VitMain/BLE-Micro-Pro/bmp-boost/bmp-boost-led-extender/bmp-boost-led-extender.kicad_pcb

## KiCad design bmp-boost/bmp-boost-led-extender/bmp-boost-led-extender.kicad_pcb (2026-06-03)

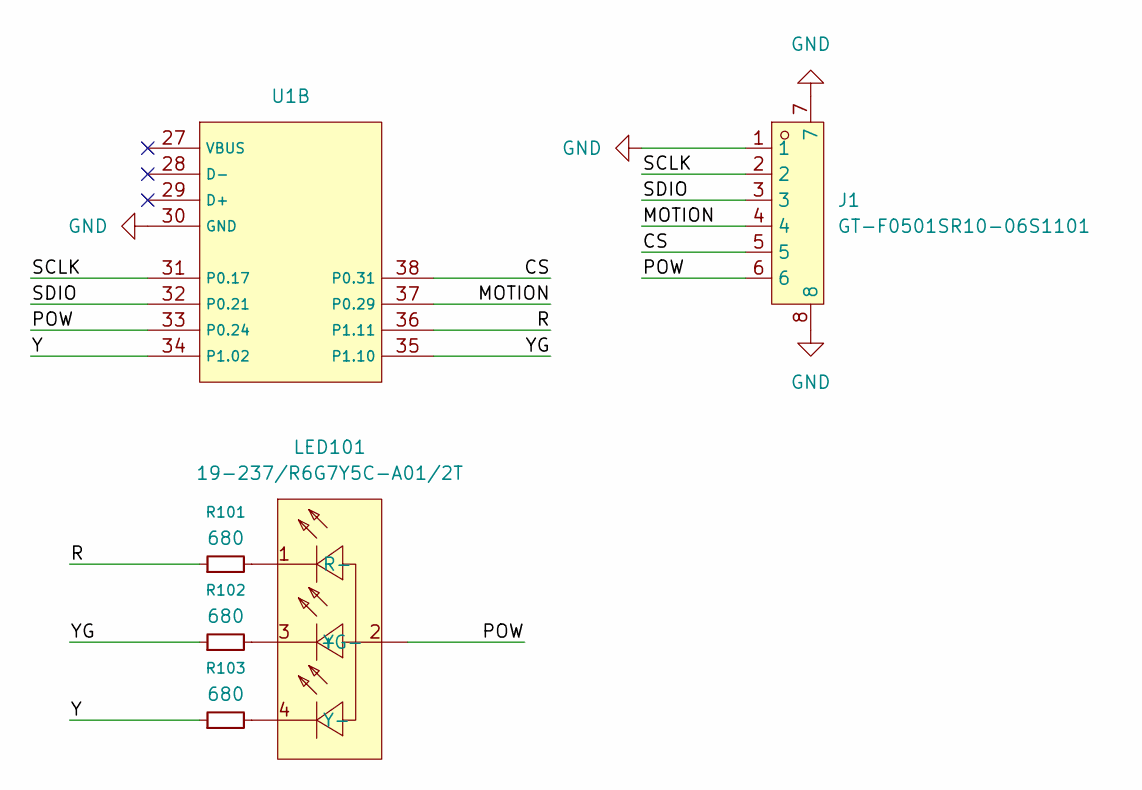
[picture p5: schematic bmp-boost-led-extender.kicad_sch]

Parts:
J1: GT-F0501SR10-06S1101; FPC-SMD_6P-P0.50_GT-F0501SR10-06S1101; LCSC Part C22380676
LED101: 19-237/R6G7Y5C-A01/2T; LED-ARRAY-SMD_4P-L1.6-W1.6-BL-CW; LCSC Part C264510
R101, R102, R103: 680; R_0603_1608Metric
U1: BMP-Boost-full

Connections:
/CS: J1.5, U1.38 (P0.31)
/MOTION: J1.4, U1.37 (P0.29)
/POW: J1.6, LED101.2 (+), U1.33 (P0.24)
/R: R101.1, U1.36 (P1.11)
/SCLK: J1.2, U1.31 (P0.17)
/SDIO: J1.3, U1.32 (P0.21)
/Y: R103.1, U1.34 (P1.02)
/YG: R102.1, U1.35 (P1.10)
GND: J1.1, J1.7, J1.8, U1.30 (GND)
unnamed: LED101.1 (R-), R101.2
unnamed: LED101.4 (Y-), R103.2
unnamed: LED101.3 (YG-), R102.2

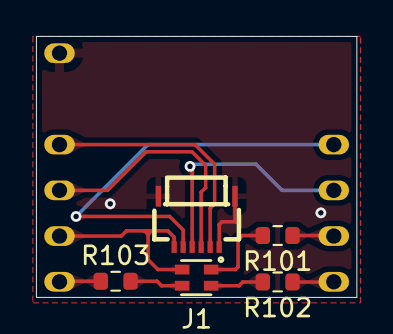
[picture p6: board bmp-boost-led-extender.kicad_pcb from above]

Board: 2 copper layers, 17.8 x 14.5 mm, 6 parts (0 on the bottom side), 12 nets.
