VitMain/BLE-Micro-Pro/bmp-boost/bmp-boost-extender/bmp-boost-extender.kicad_pcb

## KiCad design bmp-boost/bmp-boost-extender/bmp-boost-extender.kicad_pcb (2025-12-13)

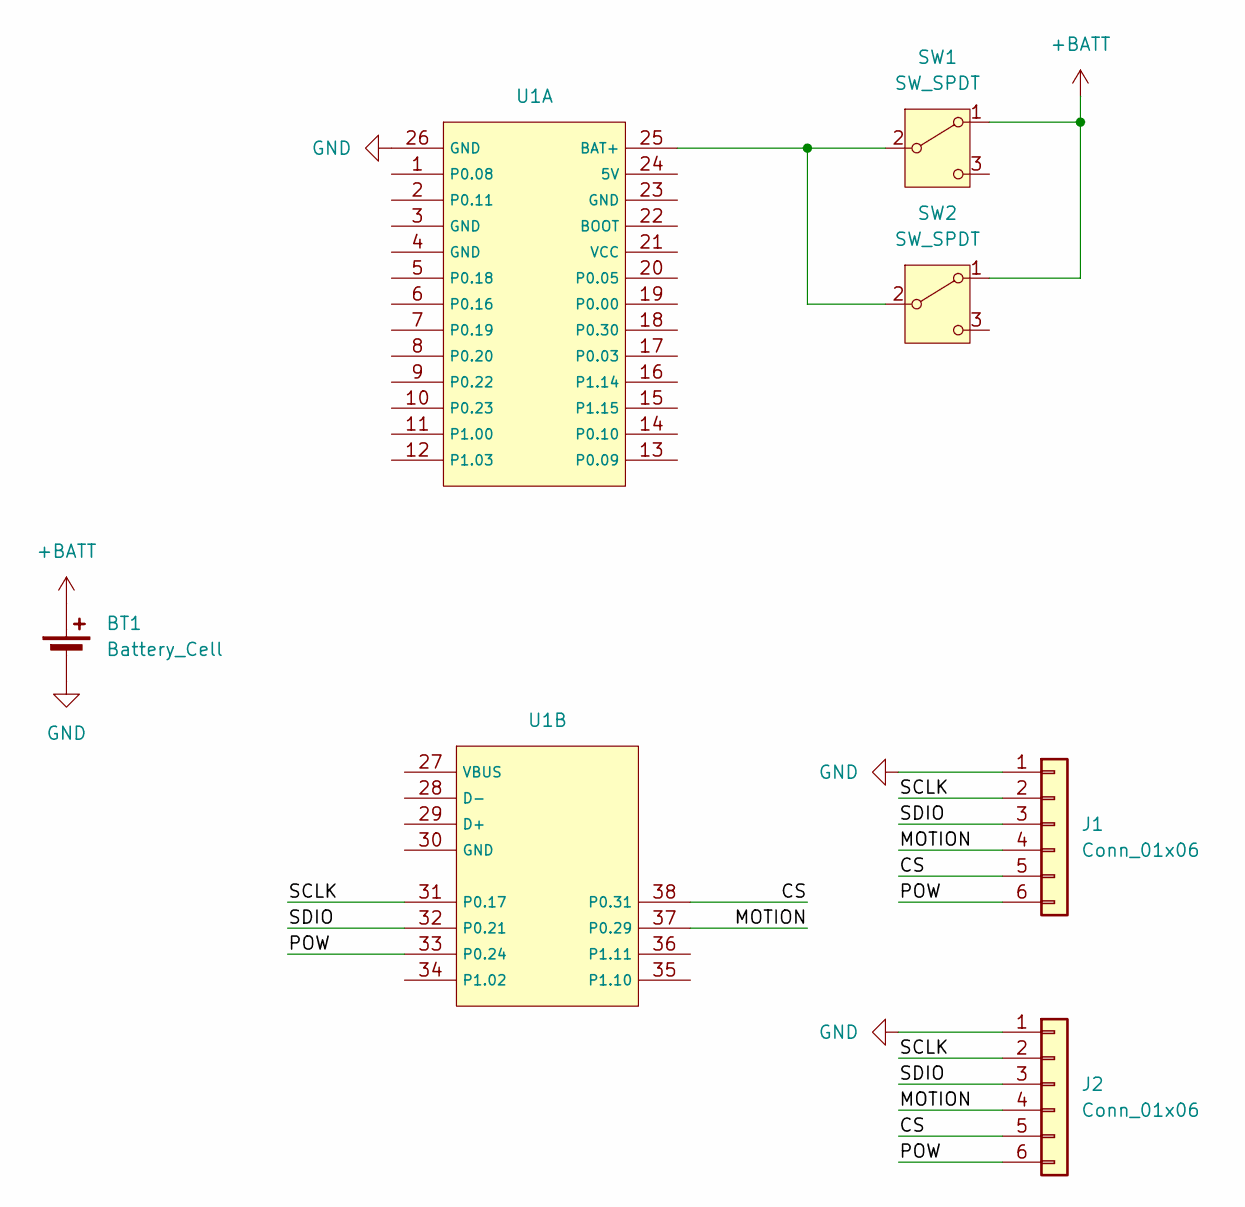
[picture p7: schematic bmp-boost-extender.kicad_sch]

Parts:
BT1: Battery_Cell; AAA_Battery_DIP
J1, J2: Conn_01x06; ffc-6p-adapter
SW1, SW2: SW_SPDT; ISH-1260-HA-G
U1: BMP-Boost-full

Connections:
+BATT: BT1.1 (+), SW1.1 (A), SW2.1 (A)
/CS: J1.5, J2.5, U1.38 (P0.31)
/MOTION: J1.4, J2.4, U1.37 (P0.29)
/POW: J1.6, J2.6, U1.33 (P0.24)
/SCLK: J1.2, J2.2, U1.31 (P0.17)
/SDIO: J1.3, J2.3, U1.32 (P0.21)
GND: BT1.2 (-), J1.1, J2.1, U1.26 (GND)
unnamed: SW1.2 (B), SW2.2 (B), U1.25 (BAT+)

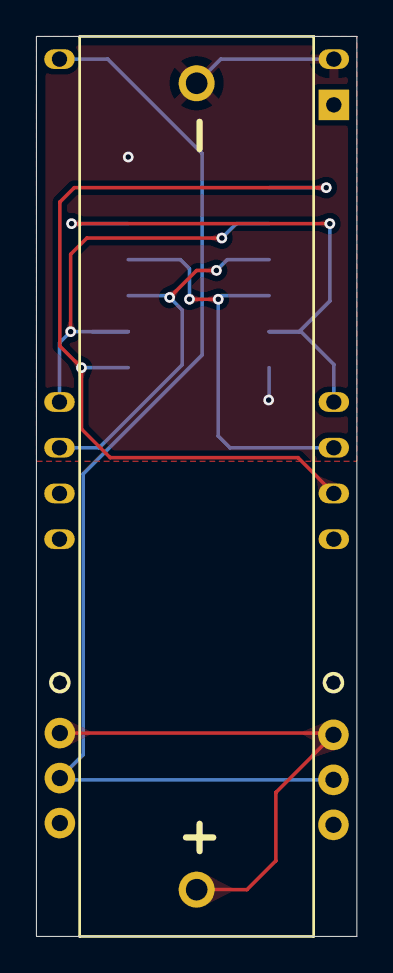
[picture p8: board bmp-boost-extender.kicad_pcb from above]

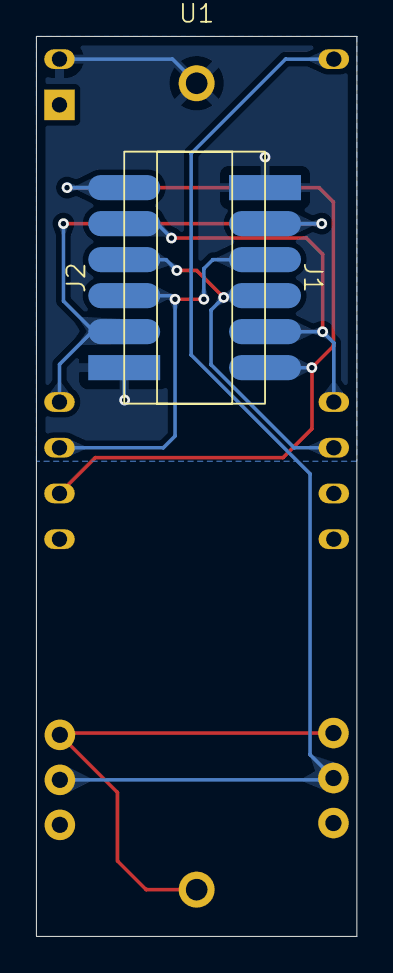
[picture p9: board bmp-boost-extender.kicad_pcb from below]

Board: 2 copper layers, 17.8 x 50.0 mm, 6 parts (4 on the bottom side), 8 nets.
