VitMain/BLE-Micro-Pro/(commit log)

2025-09-23 Add bmp-boost KiCad symbols
2025-12-13 Add bmp-boost extender
    [bmp-boost-extender.kicad_pcb, bmp-boost-extender.kicad_sch]
2026-06-03 bmp-boost-led-extenderを追加
    [bmp-boost-led-extender.kicad_pcb, bmp-boost-led-extender.kicad_sch]
